bryanbendall/Brytec_PowerModuleRev5/Board/WBDesign18.pdf

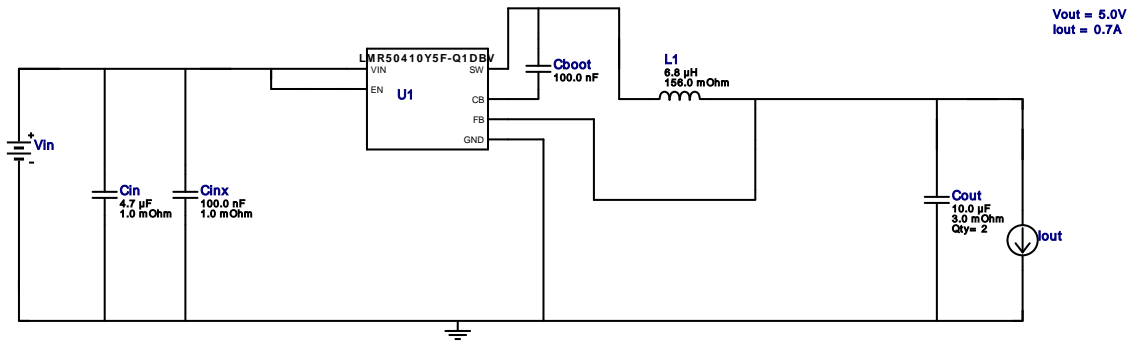
[picture p1: figure]
Cinx 100.0 nF 1.0 m Ohm; L1 6.8 µH 156.0 m Ohm; Vout = 5.0V Iout = 0.7A; Cboot 100.0 nF; Cin 4.7 µF 1.0 m Ohm; LM R5 0 4 1 0 Y5 F-Q1 DBV; GND; VIN; Cout 10.0 µF 3.0 m Ohm Qty= 2; Vin; Iout

Copyright © 2023, Texas Instruments Incorporated | 1 | ti.com/webench

WEBENCH®
Design Report LMR50410Y5FQDBVRQ1 : LMR50410Y5FQDBVRQ1 7V-36V to 5.00V @ 0.7A August 18, 2023 09:45:09 GMT-05:00

## WEBENCH ® Design Report

Design : 18 LMR50410Y5FQDBVRQ1
LMR50410Y5FQDBVRQ1 7V-36V to 5.00V @ 0.7A

VinMin = 7.0V
VinMax = 36.0V
Vout = 5.0V
Iout = 0.7A

Device = LMR50410Y5FQDBVRQ1 Topology = Buck
Created = 2023-08-18 06:29:39.527 BOM Cost = NA
BOM Count = 7
Total Pd = 1.03W

### Design Alerts

Component Selection Information
The LMR50410Y5F-Q1 is qualified for Automotive applications. All passives and other components selected in this design may not be qualified for Automotive applications. The user is required to verify that all components in the design meet the qualification and safety requirements for their specific application.

## Electrical BOM

Name | Manufacturer | Part Number | Properties | Qty Price | Footprint
Cboot | CUSTOM | CUSTOM Series= ? | Cap= 100.0 nF VDC= 16.0 V IRMS= 0.0 A
1 | NA
| | | | | CUSTOM 0 mm²
Cin | TDK | C2012X5R1H475K125AB Series= X5R | Cap= 4.7 uF ESR= 1.0 mOhm VDC= 50.0 V IRMS= 4.3 A
1 | $0.12
| | | | | 0805 7 mm²
Cinx | MuRata | GRM21BR71H104KA01L (http://search.murata.co.jp/Ceramy/PnsearchViewAction.do) Series= X7R

Cap= 100.0 nF
ESR= 1.0 mOhm
VDC= 50.0 V
IRMS= 3.85 A

1 $0.03
0805 7 mm²
Cout | Kemet | C0805C106K8PACTU (http://capacitoredge.kemet.com/capedge2/DataSheet/Datasheet%2DC0805C106K8PACTU.pdf?pn%3DC0805C106K8PACTU) Series= X5R

Cap= 10.0 uF
ESR= 3.0 mOhm
VDC= 10.0 V
IRMS= 11.43 A

2 $0.03
0805 7 mm²
L1 | Wurth Elektronik | 74405042068 (http://katalog.we%2Donline.de/pbs/datasheet/74405042068.pdf) | L= 6.8 µH 156.0 mOhm | 1 | $0.42
WE-LQSH_4020 24 mm²
U1 | Texas Instruments | LMR50410Y5FQDBVRQ1 (http://www.ti.com/product/LMR50410%2DQ1) | Switcher | 1 | $0.50

DBV0006A 15 mm²

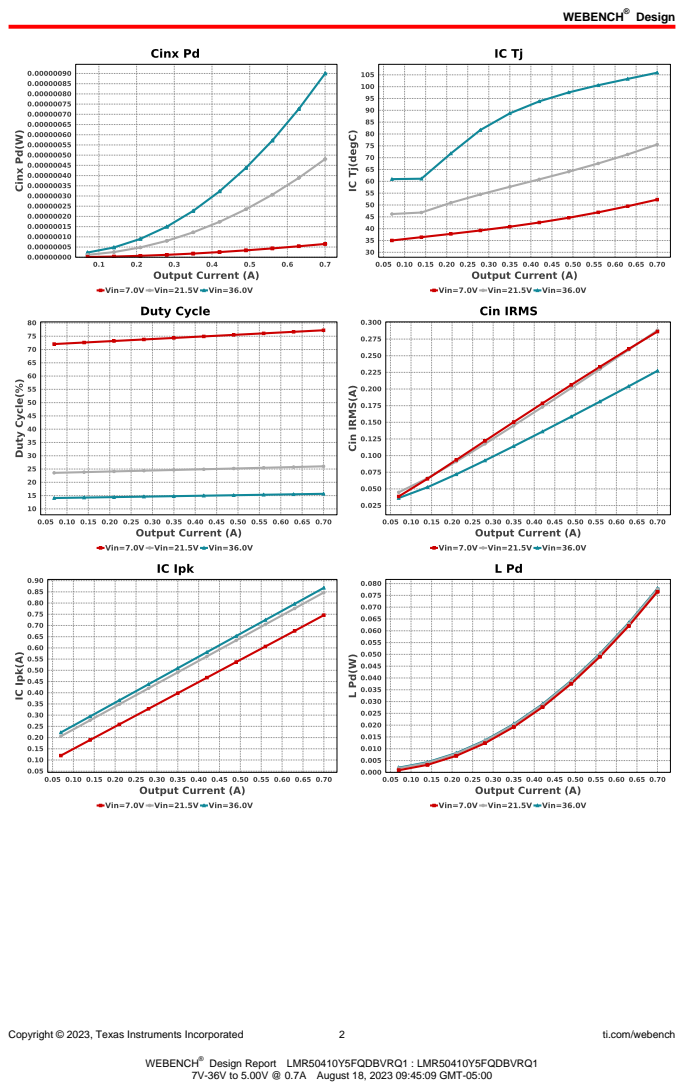
[picture p2: page 2]
Design; Copyright © 2023, Texas Instruments Incorporated; ti.com/webench

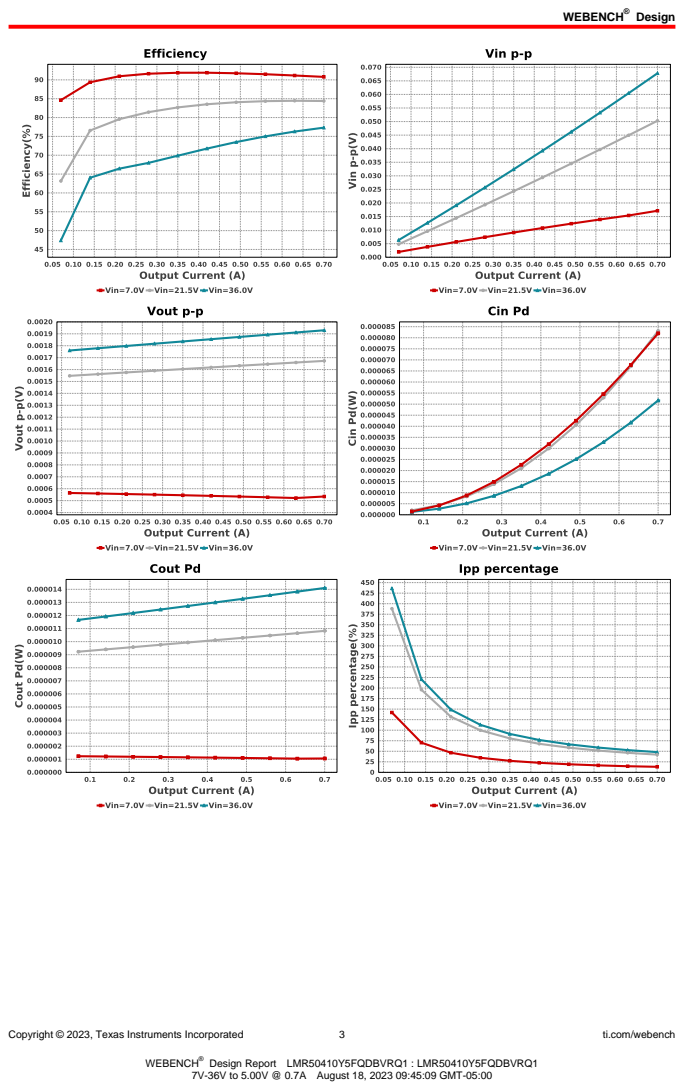
[picture p3: page 3]
Copyright © 2023, Texas Instruments Incorporated; ti.com/webench

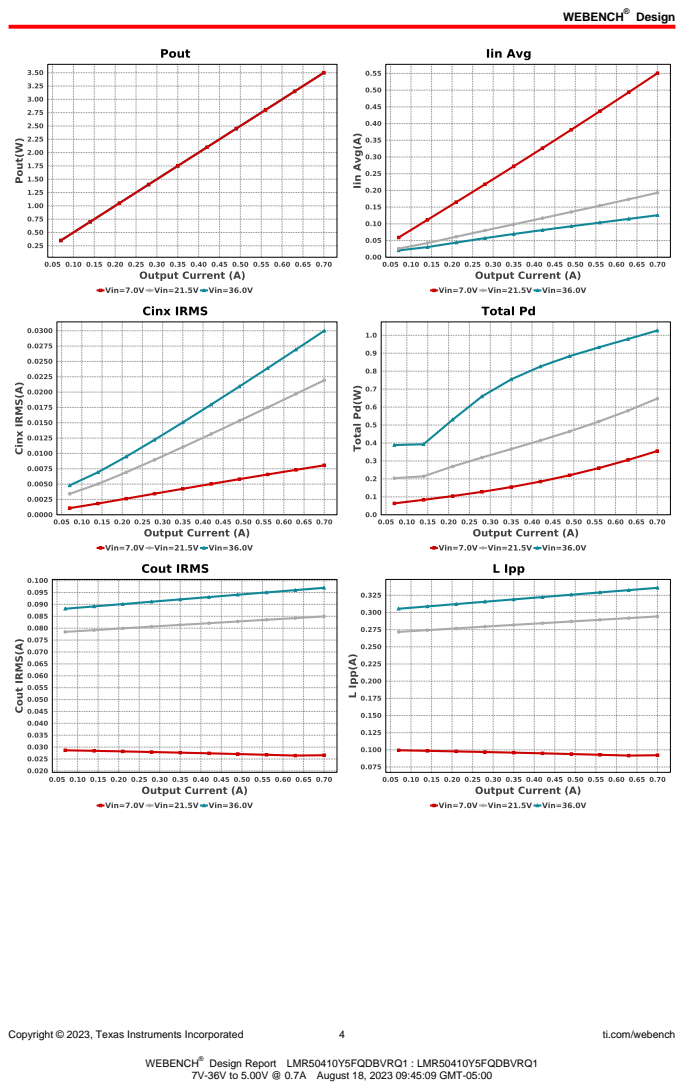
[picture p4: page 4]
Copyright © 2023, Texas Instruments Incorporated; ti.com/webench

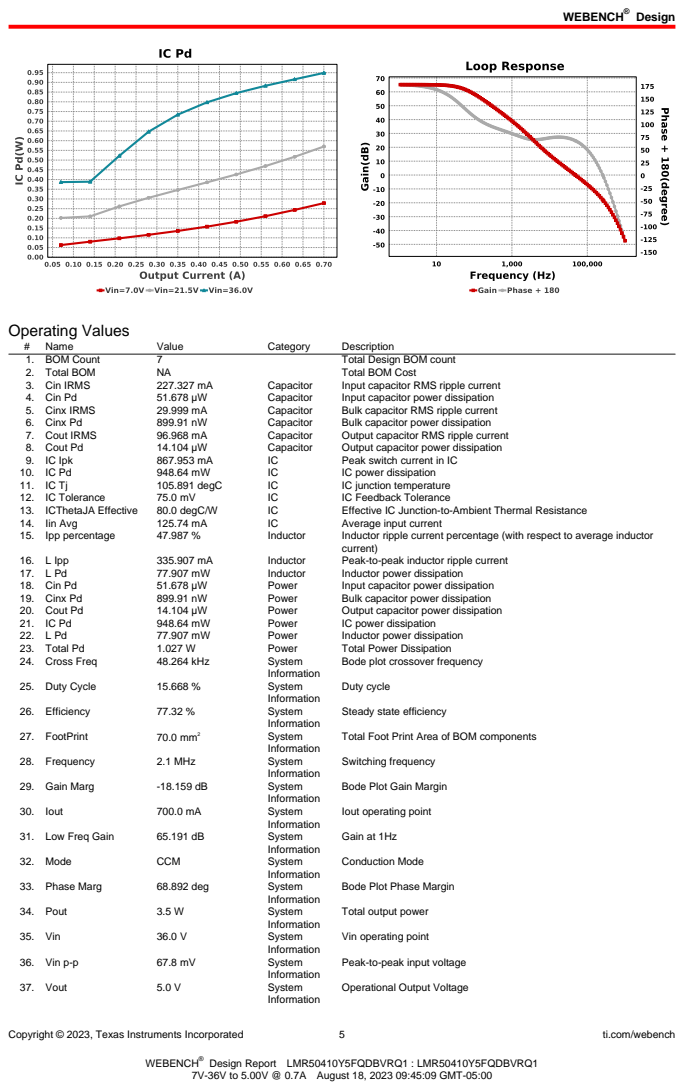
[picture p5: page 5]
Copyright © 2023, Texas Instruments Incorporated; ti.com/webench; Operating Values; Name; Value; Category; Description; 1. BOM Count; Total Design BOM count; 2. Total BOM; Total BOM Cost; 3. Cin IRMS; Capacitor; Input capacitor RMS ripple current; 4. Cin Pd; Input capacitor power dissipation; 5. Cinx IRMS; Bulk capacitor RMS ripple current; 6. Cinx Pd; Bulk capacitor power dissipation; 7. Cout IRMS; Output capacitor RMS ripple current; 8. Cout Pd; Output capacitor power dissipation; 9. IC Ipk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

Bode plot crossover frequency

Steady state efficiency

Total Foot Print Area of BOM components

Bode Plot Gain Margin

Iout operating point

Bode Plot Phase Margin

Total output power

Vin operating point

Peak-to-peak input voltage

Operational Output Voltage

Copyright © 2023, Texas Instruments Incorporated | 6 | ti.com/webench
# | Name | Value | Category | Description

38. Vout Tolerance | 1.5 % | System
| | | Information | Vout Tolerance based on IC Tolerance (no load) and voltage divider resistors if applicable
39. Vout p-p | 1.93 mV | System
| | | Information | Peak-to-peak output ripple voltage

## Design Inputs

Name | Value | Description
| Iout | | 700.0 m | Maximum Output Current
VinMax | 36.0 | Maximum input voltage
VinMin | 7.0 | Minimum input voltage
VinTyp | 14.0 | Typical input voltage
Vout | 5.0 | Output Voltage
| base_pn | | LMR50410Y5F-Q1 | Base Product Number
source | DC | Input Source Type
Ta | 30.0 | Ambient temperature


Copyright © 2023, Texas Instruments Incorporated | 7 | ti.com/webench

## Assembly

## Component Testing

Some published data on components in datasheets such as Capacitor ESR and Inductor DC resistance is based on conservative values that will guarantee that the components always exceed the specification. For design purposes it is usually better to work with typical values. Since this data is not always available it is a good practice to measure the Capacitance and ESR values of Cin and Cout, and the inductance and DC resistance of L1 before assembly of the board. Any large discrepancies in values should be electrically simulated in WEBENCH to check for instabilities and thermally simulated in WebTHERM to make sure critical temperatures are not exceeded.

## Soldering Component to Board

If board assembly is done in house it is best to tack down one terminal of a component on the board then solder the other terminal. For surface mount parts with large tabs, such as the DPAK, the tab on the back of the package should be pre-tinned with solder, then tacked into place by one of the pins. To solder the tab town to the board place the iron down on the board while resting against the tab, heating both surfaces simultaneously. Apply light pressure to the top of the plastic case until the solder flows around the part and the part is flush with the PCB. If the solder is not flowing around the board you may need a higher wattage iron (generally 25W to 30W is enough).

## Initial Startup of Circuit

It is best to initially power up the board by setting the input supply voltage to the lowest operating input voltage 7.0V and set the input supply's current limit to zero. With the input supply off connect up the input supply to Vin and GND. Connect a digital volt meter and a load if needed to set the minimum Iout of the design from Vout and GND. Turn on the input supply and slowly turn up the current limit on the input supply. If the voltage starts to rise on the input supply continue increasing the input supply current limit while watching the output voltage. If the current increases on the input supply, but the voltage remains near zero, then there may be a short or a component misplaced on the board. Power down the board and visually inspect for solder bridges and recheck the diode and capacitor polarities. Once the power supply circuit is operational then more extensive testing may include full load testing, transient load and line tests to compare with simulation results.

## Load Testing

The setup is the same as the initial startup, except that an additional digital voltmeter is connected between Vin and GND, a load is connected between Vout and GND and a current meter is connected in series between Vout and the load. The load must be able to handle at least rated output power + 50% ( 7.5 watts for this design). Ideally the load is supplied in the form of a variable load test unit. It can also be done in the form of suitably large power resistors. When using an oscilloscope to measure waveforms on the prototype board, the ground leads of the oscilloscope probes should be as short as possible and the area of the loop formed by the ground lead should be kept to a minimum. This will help reduce ground lead inductance and eliminate EMI noise that is not actually present in the circuit.

## Design Assistance

1. Master key : 9BEBB61A34925AAD[v1]
2. LMR50410Y5F-Q1 Product Folder : http://www.ti.com/product/LMR50410%2DQ1 : contains the data sheet and other resources.

Copyright © 2023, Texas Instruments Incorporated | 8 | ti.com/webench

Important Notice and Disclaimer

TI provides technical and reliability data (including datasheets), design resources (including reference designs), application or other design advice, web tools, safety information, and other resources AS IS and with all faults, and disclaims all warranties. These resources are intended for skilled developers designing with TI products. You are solely responsible for (1) selecting the appropriate TI products for your application, (2) designing, validating and testing your application, and (3) ensuring your application meets applicable standards, and any other safety, security, or other requirements.

These resources are subject to change without notice. TI grants you permission to use these resources only for development of an application that uses the TI products described in the resource. Other reproduction and display of these resources is prohibited. No license is granted to any other TI intellectual property right or to any third party intellectual property right. TI disclaims responsibility for, and you will fully indemnify TI and its representatives against, any claims, damages, costs, losses, and liabilities arising out of your use of these resources.

Providing these resources does not expand or otherwise alter TI's applicable Terms of Sale or other applicable terms available either on ti.com or provided in conjunction with TI products.
