bryanbendall/Brytec_PowerModuleRev5/Board/Power Module Rev 5/Power Module Rev 5.kicad_pcb

## KiCad design Board/Power Module Rev 5/Power Module Rev 5.kicad_pcb (2024-01-26)

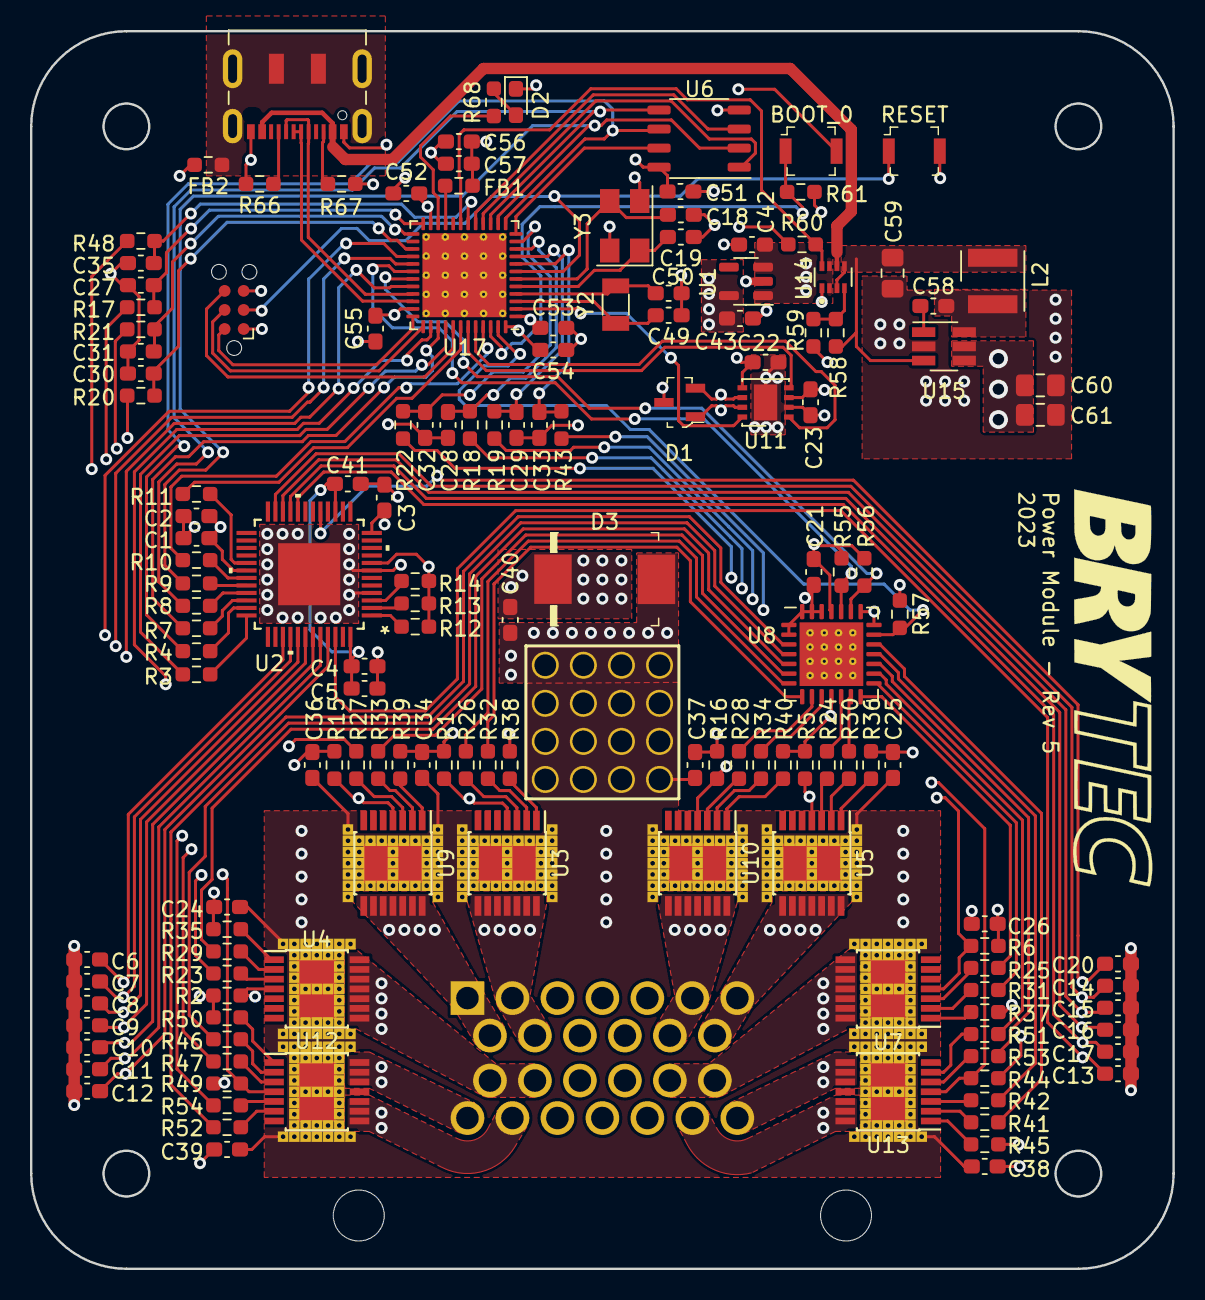
[picture p7: board Power Module Rev 5.kicad_pcb from above]

Board: 4 copper layers, 76.2 x 82.6 mm, 150 parts (0 on the bottom side), 133 nets.

Parts:
C1, C4, C42, C43, C56: 1uF; C_0603_1608Metric_Pad1.08x0.95mm_HandSolder
C2, C3, C5, C21, C22, C23, C24, C25, C26, C34, C36, C37, C38, C39, C40, C41, C51, C52, C53, C54, C55, C58: 0.1uF; C_0603_1608Metric_Pad1.08x0.95mm_HandSolder
C6, C7, C8, C9, C10, C11, C12, C13, C14, C15, C16, C17, C20: 6.8nF; C_0603_1608Metric_Pad1.08x0.95mm_HandSolder
C18, C19, C49, C50: 10pF; C_0603_1608Metric_Pad1.08x0.95mm_HandSolder
C27, C28, C29, C30, C31, C32, C33, C35: 220pF; C_0603_1608Metric_Pad1.08x0.95mm_HandSolder
C57: 10nF; C_0603_1608Metric_Pad1.08x0.95mm_HandSolder
C59: 10uF; C_0805_2012Metric_Pad1.18x1.45mm_HandSolder
C60: 0.1uF; C_0805_2012Metric_Pad1.18x1.45mm_HandSolder
C61: 4.7uF; C_0805_2012Metric_Pad1.18x1.45mm_HandSolder
D1: PESD2CAN_215; SOT-23-3
D2: LED_Small; LED_0603_1608Metric_Pad1.05x0.95mm_HandSolder
D3: SMCJ33CA; DO-214AB
FB1, FB2: FerriteBead_Small; R_0603_1608Metric_Pad0.98x0.95mm_HandSolder
J1: 9-6437287-8; TE_9-6437287-8
J2: Conn_ARM_SWD_TagConnect_TC2030-NL; Tag-Connect_TC2030-IDC-NL_2x03_P1.27mm_Vertical
J3: Conn_01x16_Pin; WP-BUFU_7461097_HAL
J4: USB_C_Receptacle_USB2.0; USB_C_Receptacle_JAE_DX07S016JA1R1500
L2: 6.8uH; L_Wurth_WE-LQSH-4020
R1, R2, R5, R6, R15, R16, R44, R49: 1.2K; R_0603_1608Metric_Pad0.98x0.95mm_HandSolder
R3, R4, R7, R8, R9, R10, R11: 1K; R_0603_1608Metric_Pad0.98x0.95mm_HandSolder
R12: 50K; R_0603_1608Metric_Pad0.98x0.95mm_HandSolder
R13: 9K; R_0603_1608Metric_Pad0.98x0.95mm_HandSolder
R14: 180; R_0603_1608Metric_Pad0.98x0.95mm_HandSolder
R17, R18, R19, R20, R21, R22, R23, R24, R25, R26, R27, R28, R29, R30, R31, R32, R33, R34, R41, R42, R43, R46, R47, R48, R51, R52, R53, R54, R55, R56: 4.7K; R_0603_1608Metric_Pad0.98x0.95mm_HandSolder
R35, R36, R37, R38, R39, R40, R45, R50: 47; R_0603_1608Metric_Pad0.98x0.95mm_HandSolder
R57, R58, R59, R60, R61: 10K; R_0603_1608Metric_Pad0.98x0.95mm_HandSolder
R66, R67: 5.1K; R_0603_1608Metric_Pad0.98x0.95mm_HandSolder
R68: 65; R_0603_1608Metric_Pad0.98x0.95mm_HandSolder
S1, S2: B3U-1000P; Switch_Tactile_SMD_B3U-1000P
U1: AP2112K-3.3; SOT-23-5
U2: L9966CB-TR; TQFP48_L9966_STM
U3, U4, U5, U7, U9, U10: BTS7002-1EPP; Infineon_PG-TSDSO-14-22 - thermal vias
U6: MB85RS64; SSOP-8_3.9x5.05mm_P1.27mm
U8: PCA9685BS; QFN-28-1EP_6x6mm_P0.65mm_EP4.25x4.25mm_ThermalVias
U11: MCP2558FD-xMF; DFN-8-1EP_3x3mm_P0.65mm_EP1.55x2.4mm
U12, U13: BTS7008-2EPA; Infineon_PG-TSDSO-14-22 - thermal vias
U14: TPS2116DRLR; SOTFL50P160X60-8N
U15: LMR50410Y5FQDBVRQ1; SOT-23-6_Handsoldering
U17: STM32G491CEUx; QFN-48-1EP_7x7mm_P0.5mm_EP5.6x5.6mm_ThermalVias
Y2: 32.768kHz; Crystal_SMD_3215-2Pin_3.2x1.5mm
Y3: 8MHz; Crystal_SMD_5032-4Pin_5.0x3.2mm

Connections:
+3.3V: C22.1, C43.1, C51.1, C52.2, C53.2, C54.2, C55.2, C56.2, C57.2, FB1.1, J2.1 (VCC), R60.1, S2.2, U1.5 (VOUT), U6.8 (VDD), U11.5 (VIO), U17.1 (VBAT), U17.23 (VDD), U17.35 (VDD), U17.48 (VDD)
+5V: C1.1, C2.1, C3.2, C21.1, C23.1, C42.1, J1.11, R12.1, R13.1, R14.1, R55.1, R56.1, R57.1, U1.1 (VIN), U1.3 (EN), U2.8 (VDD5REF), U2.12 (VI5V), U2.30 (VDD5V), U8.25 (VDD), U11.3 (VDD), U14.2 (VOUT), U14.7 (VOUT)
+12V: C4.1, C5.1, C24.1, C25.1, C26.1, C34.1, C36.1, C37.1, C38.1, C39.1, C40.1, C41.2, D3.2 (A2), J3.1, J3.2, J3.3, J3.4, J3.5, J3.6, J3.7, J3.8, J3.9, J3.10, J3.11, J3.12, J3.13, J3.14, J3.15, J3.16, U2.15 (VIX), U2.48 (UBSW), U3.15 (VS), U4.15 (VS), U5.15 (VS), U7.15 (VS), U9.15 (VS), U10.15 (VS), U12.15 (VS), U13.15 (VS)
/High Side Drivers/Den1: R26.2, U8.7 (LED4)
/High Side Drivers/Den3: R24.2, U8.12 (LED8)
/High Side Drivers/Den4: R25.2, U8.14 (LED10)
/High Side Drivers/Den6: R28.2, U8.9 (LED6)
/High Side Drivers/Den9-10: R42.2, U8.18 (LED14)
/High Side Drivers/Dsel9-10: R53.2, U8.17 (LED13)
/High Side Drivers/In1: R32.2, U8.8 (LED5)
/High Side Drivers/In2: R29.2, U8.5 (LED2)
/High Side Drivers/In3: R30.2, U8.13 (LED9)
/High Side Drivers/In4: R31.2, U8.15 (LED11)
/High Side Drivers/In5: R33.2, U8.6 (LED3)
/High Side Drivers/In6: R34.2, U8.10 (LED7)
/High Side Drivers/In7: R46.2, U8.4 (LED1)
/High Side Drivers/In8: R52.2, U8.3 (LED0)
/High Side Drivers/In9: R41.2, U8.19 (LED15)
/High Side Drivers/In10: R51.2, U8.16 (LED12)
/Mcu/BOOT_0: R61.1, S2.1, U17.46 (PB8)
/Mcu/Memory_Hold: U6.7 (~HOLD), U17.12 (PA4)
/Mcu/Memory_Wp: U6.3 (~WP), U17.17 (PB0)
/Mcu/RESET: J2.3 (~RESET), S1.1, U17.7 (PG10)
/Mcu/SPI1_SS_Memory: U6.1 (~CS), U17.16 (PC4)
/Mcu/SWCLK: J2.4 (SWCLK), U17.37 (PA14)
/Mcu/SWDIO: J2.2 (SWDIO), U17.36 (PA13)
/Mcu/SWO: J2.6 (SWO), U17.41 (PB3)
/Mcu/Usb D+: J4.A6 (D+), J4.B6 (D+), U17.34 (PA12)
/Mcu/Usb D-: J4.A7 (D-), J4.B7 (D-), U17.33 (PA11)
/Mcu/Usb_Shield: FB2.1, J4.S1 (SHIELD)
/Mcu/User_Led: R68.1, U17.22 (PB10)
Can+: D1.1 (C1), J1.4, U11.7 (CANH)
Can-: D1.2 (C2), J1.3, U11.6 (CANL)
CanRx: U11.4 (RXD), U17.43 (PB5)
CanSilent: U11.8 (S), U17.2 (PC13)
CanTx: U11.1 (TXD), U17.44 (PB6)
Den2: R23.2, U17.28 (PB15)
Den5: R27.2, U17.38 (PA15)
Den7-8: R47.2, U17.32 (PA10)
Dsel7-8: R54.2, U17.29 (PC6)
GND: C1.2, C2.2, C3.1, C4.2, C5.2, C6.2, C7.2, C8.2, C9.2, C10.2, C11.2, C12.2, C13.2, C14.2, C15.2, C16.2, C17.2, C18.1, C19.1, C20.2, C21.2, C22.2, C23.2, C24.2, C25.2, C26.2, C27.2, C28.2, C29.2, C30.2, C31.2, C32.2, C33.2, C34.2, C35.2, C36.2, C37.2, C38.2, C39.2, C40.2, C41.1, C42.2, C43.2, C49.1, C50.1, C51.2, C52.1, C53.1, C54.1, C55.1, C56.1, C57.1, C59.2, C60.2, C61.2, D1.3 (C3), D2.1 (K), D3.1 (A1), FB2.2, J1.10, J1.16, J1.17, J2.5 (GND), J4.A1 (GND), J4.A12 (GND), J4.B1 (GND), J4.B12 (GND), R1.2, R2.2, R5.2, R6.2, R15.2, R16.2, R35.2, R36.2, R37.2, R38.2, R39.2, R40.2, R44.2, R45.2, R49.2, R50.2, R59.2, R61.2, R66.2, R67.2, S1.2, U1.2 (GND), U2.4 (R_GND), U2.7 (GND), U2.EPAD, U6.4 (GND), U8.1 (A3), U8.2 (A4), U8.11 (VSS), U8.21 (A5), U8.22 (EXTCLK), U8.26 (A0), U8.27 (A1), U8.28 (A2), U8.29 (VSS), U11.2 (VSS), U11.9 (VSS), U14.1 (GND), U15.2 (GND), U17.49 (VSS), Y3.2, Y3.4
Ignition: C60.1, C61.1, J1.5, U15.4 (EN), U15.5 (VIN)
Input1: C13.1, J1.24, U2.46 (IO_5)
Input2: C12.1, J1.23, U2.45 (IO_6)
Input3: C11.1, J1.22, U2.44 (IO_7)
Is1: C30.1, R20.2, U17.27 (PB14)
Is2: C27.1, R17.2, U17.24 (PB11)
Is3: C28.1, R18.2, U17.10 (PA2)
Is4: C29.1, R19.2, U17.9 (PA1)
Is5: C31.1, R21.2, U17.25 (PB12)
Is6: C32.1, R22.2, U17.11 (PA3)
Is7-8: C35.1, R48.2, U17.18 (PB1)
Is9-10: C33.1, R43.2, U17.8 (PA0)
L6699-Int: R11.2, U17.42 (PB4)
L6699-Rst: R3.2, U17.40 (PC11)
L6699-Sync: R10.2, U17.45 (PB7)
unnamed: D2.2 (A), R68.2
unnamed: J4.A5 (CC1), R67.1
unnamed: J4.B5 (CC2), R66.1
unnamed: R7.1, U2.34 (CS)
unnamed: R11.1, U2.29 (INT)
unnamed: R9.1, U2.32 (MISO)
unnamed: R8.1, U2.33 (MOSI)
unnamed: R14.2, U2.3 (RR1)
unnamed: R13.2, U2.2 (RR2)
unnamed: R12.2, U2.1 (RR3)
unnamed: R3.1, U2.36 (RST)
unnamed: R4.1, U2.35 (SCLK)
unnamed: R10.1, U2.31 (SYNC)
unnamed: R26.1, U3.3 (DEN)
unnamed: R38.1, U3.1 (GND)
unnamed: R32.1, U3.2 (IN)
unnamed: R1.1, R20.1, U3.4 (IS)
unnamed: R23.1, U4.3 (DEN)
unnamed: R35.1, U4.1 (GND)
unnamed: R29.1, U4.2 (IN)
unnamed: R2.1, R17.1, U4.4 (IS)
unnamed: R24.1, U5.3 (DEN)
unnamed: R36.1, U5.1 (GND)
unnamed: R30.1, U5.2 (IN)
unnamed: R5.1, R18.1, U5.4 (IS)
unnamed: R25.1, U7.3 (DEN)
unnamed: R37.1, U7.1 (GND)
unnamed: R31.1, U7.2 (IN)
unnamed: R6.1, R19.1, U7.4 (IS)
unnamed: R27.1, U9.3 (DEN)
unnamed: R39.1, U9.1 (GND)
unnamed: R33.1, U9.2 (IN)
unnamed: R15.1, R21.1, U9.4 (IS)
unnamed: R28.1, U10.3 (DEN)
unnamed: R40.1, U10.1 (GND)
unnamed: R34.1, U10.2 (IN)
unnamed: R16.1, R22.1, U10.4 (IS)
unnamed: R47.1, U12.3 (DEN)
unnamed: R54.1, U12.5 (DSEL)
unnamed: R50.1, U12.1 (GND)
unnamed: R46.1, U12.2 (IN0)
unnamed: R52.1, U12.6 (IN1)
unnamed: R48.1, R49.1, U12.4 (IS)
unnamed: R42.1, U13.3 (DEN)
unnamed: R53.1, U13.5 (DSEL)
unnamed: R45.1, U13.1 (GND)
unnamed: R41.1, U13.2 (IN0)
unnamed: R51.1, U13.6 (IN1)
unnamed: R43.1, R44.1, U13.4 (IS)
unnamed: R58.2, R59.1, U14.4 (PR1)
unnamed: C58.2, U15.1 (CB)
unnamed: C58.1, L2.1, U15.6 (SW)
unnamed: C49.2, U17.3 (PC14), Y2.2
unnamed: C50.2, U17.4 (PC15), Y2.1
unnamed: C19.2, U17.5 (PF0), Y3.1
unnamed: C18.2, U17.6 (PF1), Y3.3
unnamed: FB1.2, U17.21 (VDDA)
Output1: C7.1, J1.2, J1.9, U2.40 (IO_11), U3.8 (OUT), U3.9 (OUT), U3.10 (OUT), U3.11 (OUT), U3.12 (OUT), U3.13 (OUT), U3.14 (OUT)
Output2: C8.1, J1.14, J1.15, U2.41 (IO_10), U4.8 (OUT), U4.9 (OUT), U4.10 (OUT), U4.11 (OUT), U4.12 (OUT), U4.13 (OUT), U4.14 (OUT)
Output3: C20.1, J1.7, J1.13, U2.17 (IO_13), U5.8 (OUT), U5.9 (OUT), U5.10 (OUT), U5.11 (OUT), U5.12 (OUT), U5.13 (OUT), U5.14 (OUT)
Output4: C15.1, J1.18, J1.19, U2.22 (IO_3), U7.8 (OUT), U7.9 (OUT), U7.10 (OUT), U7.11 (OUT), U7.12 (OUT), U7.13 (OUT), U7.14 (OUT)
Output5: C6.1, J1.1, J1.8, U2.39 (IO_12), U9.8 (OUT), U9.9 (OUT), U9.10 (OUT), U9.11 (OUT), U9.12 (OUT), U9.13 (OUT), U9.14 (OUT)
Output6: C14.1, J1.6, J1.12, U2.23 (IO_4), U10.8 (OUT), U10.9 (OUT), U10.10 (OUT), U10.11 (OUT), U10.12 (OUT), U10.13 (OUT), U10.14 (OUT)
Output7: C9.1, J1.20, U2.42 (IO_9), U12.12 (OUT0), U12.13 (OUT0), U12.14 (OUT0)
Output8: C10.1, J1.21, U2.43 (IO_8), U12.8 (OUT1), U12.9 (OUT1), U12.10 (OUT1)
Output9: C17.1, J1.25, U2.20 (IO_1), U13.12 (OUT0), U13.13 (OUT0), U13.14 (OUT0)
Output10: C16.1, J1.26, U2.21 (IO_2), U13.8 (OUT1), U13.9 (OUT1), U13.10 (OUT1)
PowerSwitchStatus: R60.2, U14.8 (ST), U17.19 (PB2)
Pwm_Ctr_Enable: R57.2, U8.20 (~OE), U17.47 (PB9)
Regulated 5V: C59.1, L2.2, R58.1, U14.3 (VIN1), U14.5 (MODE), U15.3 (FB)
SCL: R56.2, U8.23 (SCL), U17.31 (PA9)
SDA: R55.2, U8.24 (SDA), U17.30 (PA8)
SPI1_Miso: R9.2, U6.2 (SO), U17.14 (PA6)
SPI1_Mosi: R8.2, U6.5 (SI), U17.15 (PA7)
SPI1_SS_L9966: R7.2, U17.39 (PC10)
SPI1_Sclk: R4.2, U6.6 (SCK), U17.13 (PA5)
Usb 5V: J4.A4 (VBUS), J4.A9 (VBUS), J4.B4 (VBUS), J4.B9 (VBUS), U14.6 (VIN2)
