bryanbendall/Brytec_PowerModuleRev5/Board/Adc Adapter/Adc Adapter.kicad_pcb

## KiCad design Board/Adc Adapter/Adc Adapter.kicad_pcb (2023-10-28)

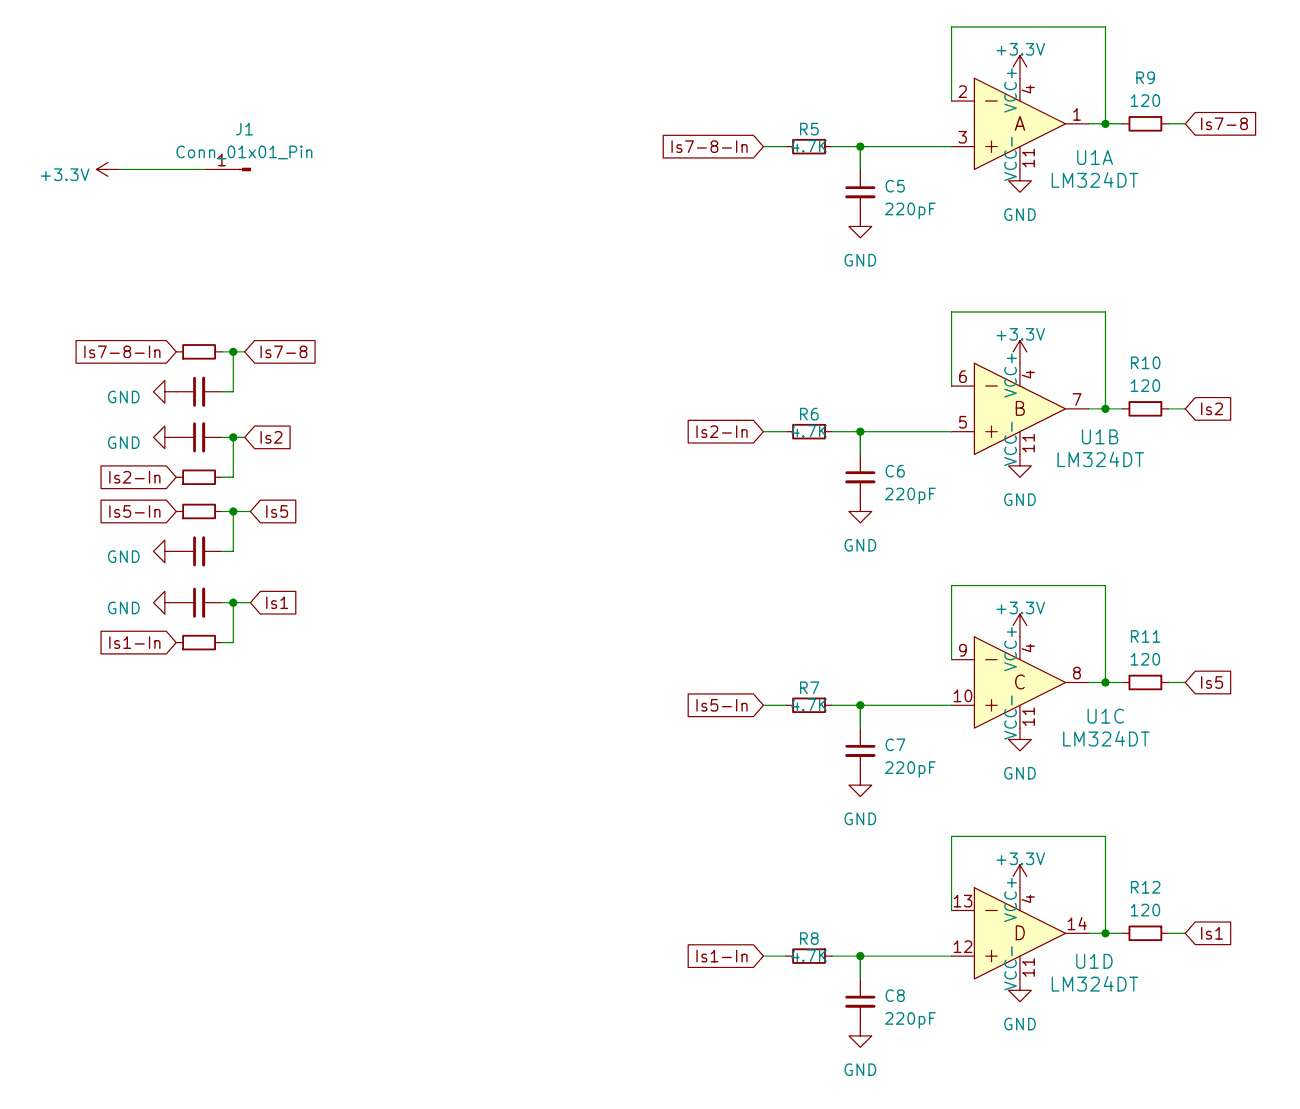
[picture p8: schematic Adc Adapter.kicad_sch]

Parts:
C1, C2, C3, C4: C_Small; C_0603_1608Metric_Adaptor
C5, C6, C7, C8: 220pF; C_0603_1608Metric_Pad1.08x0.95mm_HandSolder
J1: Conn_01x01_Pin; PinHeader_1x01_P2.00mm_Vertical
R1, R2, R3, R4: R_Small; C_0603_1608Metric_Adaptor
R5, R6, R7, R8: 4.7K; R_0603_1608Metric_Pad0.98x0.95mm_HandSolder
R9, R10, R11, R12: 120; R_0603_1608Metric_Pad0.98x0.95mm_HandSolder
U1: LM324DT; SOIC-14_W3.9mm; MPN LM324DT; Digi-Key_PN 497-1580-1-ND

Connections:
+3.3V: J1.1, U1.4 (VCC+)
GND: C1.1, C2.1, C3.1, C4.1, C5.2, C6.2, C7.2, C8.2, U1.11 (VCC-)
Is1: C4.2, R4.2, R12.1
Is1-In: R4.1, R8.2
Is2: C2.2, R2.2, R10.1
Is2-In: R2.1, R6.2
Is5: C3.2, R3.2, R11.1
Is5-In: R3.1, R7.2
Is7-8: C1.2, R1.2, R9.1
Is7-8-In: R1.1, R5.2
unnamed: C5.1, R5.1, U1.3
unnamed: C6.1, R6.1, U1.5
unnamed: C7.1, R7.1, U1.10
unnamed: C8.1, R8.1, U1.12
unnamed: R9.2, U1.1, U1.2
unnamed: R10.2, U1.6, U1.7
unnamed: R11.2, U1.8, U1.9
unnamed: R12.2, U1.13, U1.14

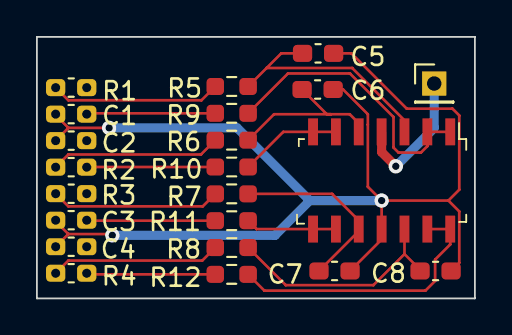
[picture p9: board Adc Adapter.kicad_pcb from above]

Board: 2 copper layers, 24.3 x 14.5 mm, 22 parts (0 on the bottom side), 18 nets.
