bryanbendall/Brytec_PowerModuleRev5/Firmware/App/BoardHardware.h

#pragma once

#include <stdint.h>

class BoardHardware {

public:
    static void setSpiMemory();
    static void setSpiL9966();

    static void calibrateAdc();
    static void readNextAdc();
    static void printAllAdc();
    static uint16_t getAdcData(uint8_t index);

    static bool getIgntionPowerState();
};
