bryanbendall/Brytec_PowerModuleRev5/Firmware/App/PowerModuleRev5Defs.h

#pragma once

#include <stdint.h>

// Pin Defines
#define BT_PIN_Onboard_LED 0
#define BT_PIN_Pin_1_and_8 1
#define BT_PIN_Pin_2_and_9 2
#define BT_PIN_Pin_6_and_12 3
#define BT_PIN_Pin_7_and_13 4
#define BT_PIN_Pin_14_and_15 5
#define BT_PIN_Pin_18_and_19 6
#define BT_PIN_Pin_20 7
#define BT_PIN_Pin_21 8
#define BT_PIN_Pin_22 9
#define BT_PIN_Pin_23 10
#define BT_PIN_Pin_24 11
#define BT_PIN_Pin_25 12
#define BT_PIN_Pin_26 13

// Can Bus Defines
#define BT_CAN_Pin_4_Pin_3 0

// Module Template
constexpr uint8_t moduleTemplate[] = {
0x54,0x4d,0,0x1,0x12,0,0,0,0x50,0x6f,0x77,0x65,0x72,0x20,0x4d,0x6f,0x64,0x75,0x6c,0x65,0x20,0x52,0x65,0x76,0x20,0x35,0x6,0,0,0,0x42,0x72,0x79,0x74,0x65,0x63,0x12,0,0,0,0x50,0x6f,0x77,0x65,0x72,0x20,0x4d,0x6f,0x64,0x75,0x6c,0x65,0x20,0x52,0x65,0x76,0x20,0x35,0x46,0x1,0x5,0,0,0,0x50,0x69,0x6e,0x20,0x34,0x5,0,0,0,0x50,0x69,0x6e,0x20,0x33,0xe,0,0xb,0,0,0,0x4f,0x6e,0x62,0x6f,0x61,0x72,0x64,0x20,0x4c,0x45,0x44,0x1,0x1,0,0,0xb,0,0,0,0x50,0x69,0x6e,0x20,0x31,0x20,0x61,0x6e,0x64,0x20,0x38,0x7,0x2,0x4,0x5,0x6,0x7,0x8,0x9,0x14,0x1,0xb,0,0,0,0x50,0x69,0x6e,0x20,0x32,0x20,0x61,0x6e,0x64,0x20,0x39,0x7,0x2,0x4,0x5,0x6,0x7,0x8,0x9,0x14,0x1,0xc,0,0,0,0x50,0x69,0x6e,0x20,0x36,0x20,0x61,0x6e,0x64,0x20,0x31,0x32,0x7,0x2,0x4,0x5,0x6,0x7,0x8,0x9,0x14,0x1,0xc,0,0,0,0x50,0x69,0x6e,0x20,0x37,0x20,0x61,0x6e,0x64,0x20,0x31,0x33,0x4,0x2,0x5,0x4,0x6,0x14,0x1,0xd,0,0,0,0x50,0x69,0x6e,0x20,0x31,0x34,0x20,0x61,0x6e,0x64,0x20,0x31,0x35,0x7,0x2,0x4,0x5,0x6,0x7,0x8,0x9,0x14,0x1,0xd,0,0,0,0x50,0x69,0x6e,0x20,0x31,0x38,0x20,0x61,0x6e,0x64,0x20,0x31,0x39,0x7,0x2,0x4,0x5,0x6,0x7,0x8,0x9,0x14,0x1,0x6,0,0,0,0x50,0x69,0x6e,0x20,0x32,0x30,0x7,0x2,0x4,0x5,0x6,0x7,0x8,0x9,0x8,0x1,0x6,0,0,0,0x50,0x69,0x6e,0x20,0x32,0x31,0x7,0x2,0x4,0x5,0x6,0x7,0x8,0x9,0x8,0x1,0x6,0,0,0,0x50,0x69,0x6e,0x20,0x32,0x32,0x6,0x4,0x5,0x6,0x7,0x8,0x9,0,0,0x6,0,0,0,0x50,0x69,0x6e,0x20,0x32,0x33,0x6,0x8,0x4,0x5,0x6,0x7,0x9,0,0,0x6,0,0,0,0x50,0x69,0x6e,0x20,0x32,0x34,0x6,0x8,0x4,0x5,0x6,0x7,0x9,0,0,0x6,0,0,0,0x50,0x69,0x6e,0x20,0x32,0x35,0x7,0x2,0x4,0x5,0x6,0x7,0x8,0x9,0x8,0x1,0x6,0,0,0,0x50,0x69,0x6e,0x20,0x32,0x36,0x7,0x2,0x4,0x5,0x6,0x7,0x8,0x9,0x8,0x1,
};
