bryanbendall/Brytec_PowerModuleRev5/(commit log)

2023-07-27 Working on board
    [CanBus.kicad_sch, Connectors.kicad_sch, DualOutput.kicad_sch, HiSideDriveHighPower.kicad_sch, HighSideDrivers.kicad_sch, L9966.kicad_sch, Mcu.kicad_sch, Power Module Rev 5.kicad_pcb]
2023-07-27 Ti power supply pdf
2023-07-30 Board Progress
    [CanBus.kicad_sch, Connectors.kicad_sch, Power Module Rev 5.kicad_pcb, PowerRegulation.kicad_sch]
2023-08-04 Update Board
    [Connectors.kicad_sch, HighSideDrivers.kicad_sch, L9966.kicad_sch, Mcu.kicad_sch, Power Module Rev 5.kicad_pcb]
2023-08-09 Board Update
    [CanBus.kicad_sch, Connectors.kicad_sch, HighSideDrivers.kicad_sch, L9966.kicad_sch, Mcu.kicad_sch, Power Module Rev 5.kicad_pcb, PowerRegulation.kicad_sch]
2023-08-14 Update config and renames on schematic
    [L9966.kicad_sch, Mcu.kicad_sch, Power Module Rev 5.kicad_pcb, PowerRegulation.kicad_sch]
2023-08-19 Board - changed regulator
    [Power Module Rev 5.kicad_pcb, PowerRegulation.kicad_sch]
2023-08-23 Board Update and Gerbers
    [Connectors.kicad_sch, DualOutput.kicad_sch, HighSideDrivers.kicad_sch, L9966.kicad_sch, Mcu.kicad_sch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]
2023-08-23 Initial Generated Stm32 Code
2023-09-20 Board update and bom page
2023-09-20 Board defs, debug printing
2023-09-20 Moved stm32 files to submodule
2023-09-29 Update for board files and power outputs Added float printf
2023-09-29 Stm32Files Submodule
2023-10-01 Control diagnostic pins Reorganize Start adc Read power switch state
2023-10-06 Working adc
2023-10-10 Slow adc reading Setup dual output chips
2023-10-17 Refactor to board hardware file Reading pin voltage starting
2023-10-17 Added adc adapter board
    [Adc Adapter.kicad_pcb, Adc Adapter.kicad_sch]
2023-10-20 Working voltage and resistance
2023-10-22 Reorganize and clean up board file
2023-10-28 Adc adapter gerber outputs
    [Adc Adapter-B_Cu.gbl, Adc Adapter-B_Mask.gbs, Adc Adapter-B_Paste.gbp, Adc Adapter-B_Silkscreen.gbo, Adc Adapter-Edge_Cuts.gm1, Adc Adapter-F_Cu.gtl, Adc Adapter-F_Mask.gts, Adc Adapter-F_Paste.gtp]
2023-10-28 Reorder for L9966 before loading config Checking ignition power state
2023-11-20 Enable Can interrupt Updates for submodule
2024-01-26 Board - fixed connector pin numbering
    [Connectors.kicad_sch, Power Module Rev 5.kicad_pcb]
2024-01-26 Fixed pin numbering Update can for changes in submodule
    [CanBusDefs.h, PowerModuleRev5Board.cpp, PowerModuleRev5Defs.h, cppMain.cpp]
2024-01-31 Moved board input and output files to submodule
2024-02-01 Setup can bus
2024-03-09 Refactor for submodule ms timers
2024-07-19 Remove reading pin voltage Updates for submodules
2025-08-30 Updated submodules Init l9966 if 12v applied
